pohlinkzei/PWM-Buck/README.md

# PWM-Buck
AVR-based control unit for car heating and ventilation in combination with an auxiliary heating

Its based on a Atmega88/168/328 AVR with a buck-converter power amplifier. It is made to driva a 
200W Motor for car heating and to display the water temperature, the temperature of the power 
transistors and the battery voltage. 

Here is where the development begun:
http://www.t4forum.de/wbb3/board19-technik-bereich/board120-umbauten-tuning/board8-tipps-und-tricks/165848-gemeinschaftsentwicklung-t4forums-pwm-modul/
