pohlinkzei/PWM-Buck/PWM-Buck/layout/PWM Buck V1.brd

## EAGLE design PWM-Buck/layout/PWM Buck V1.brd (2016-06-30)

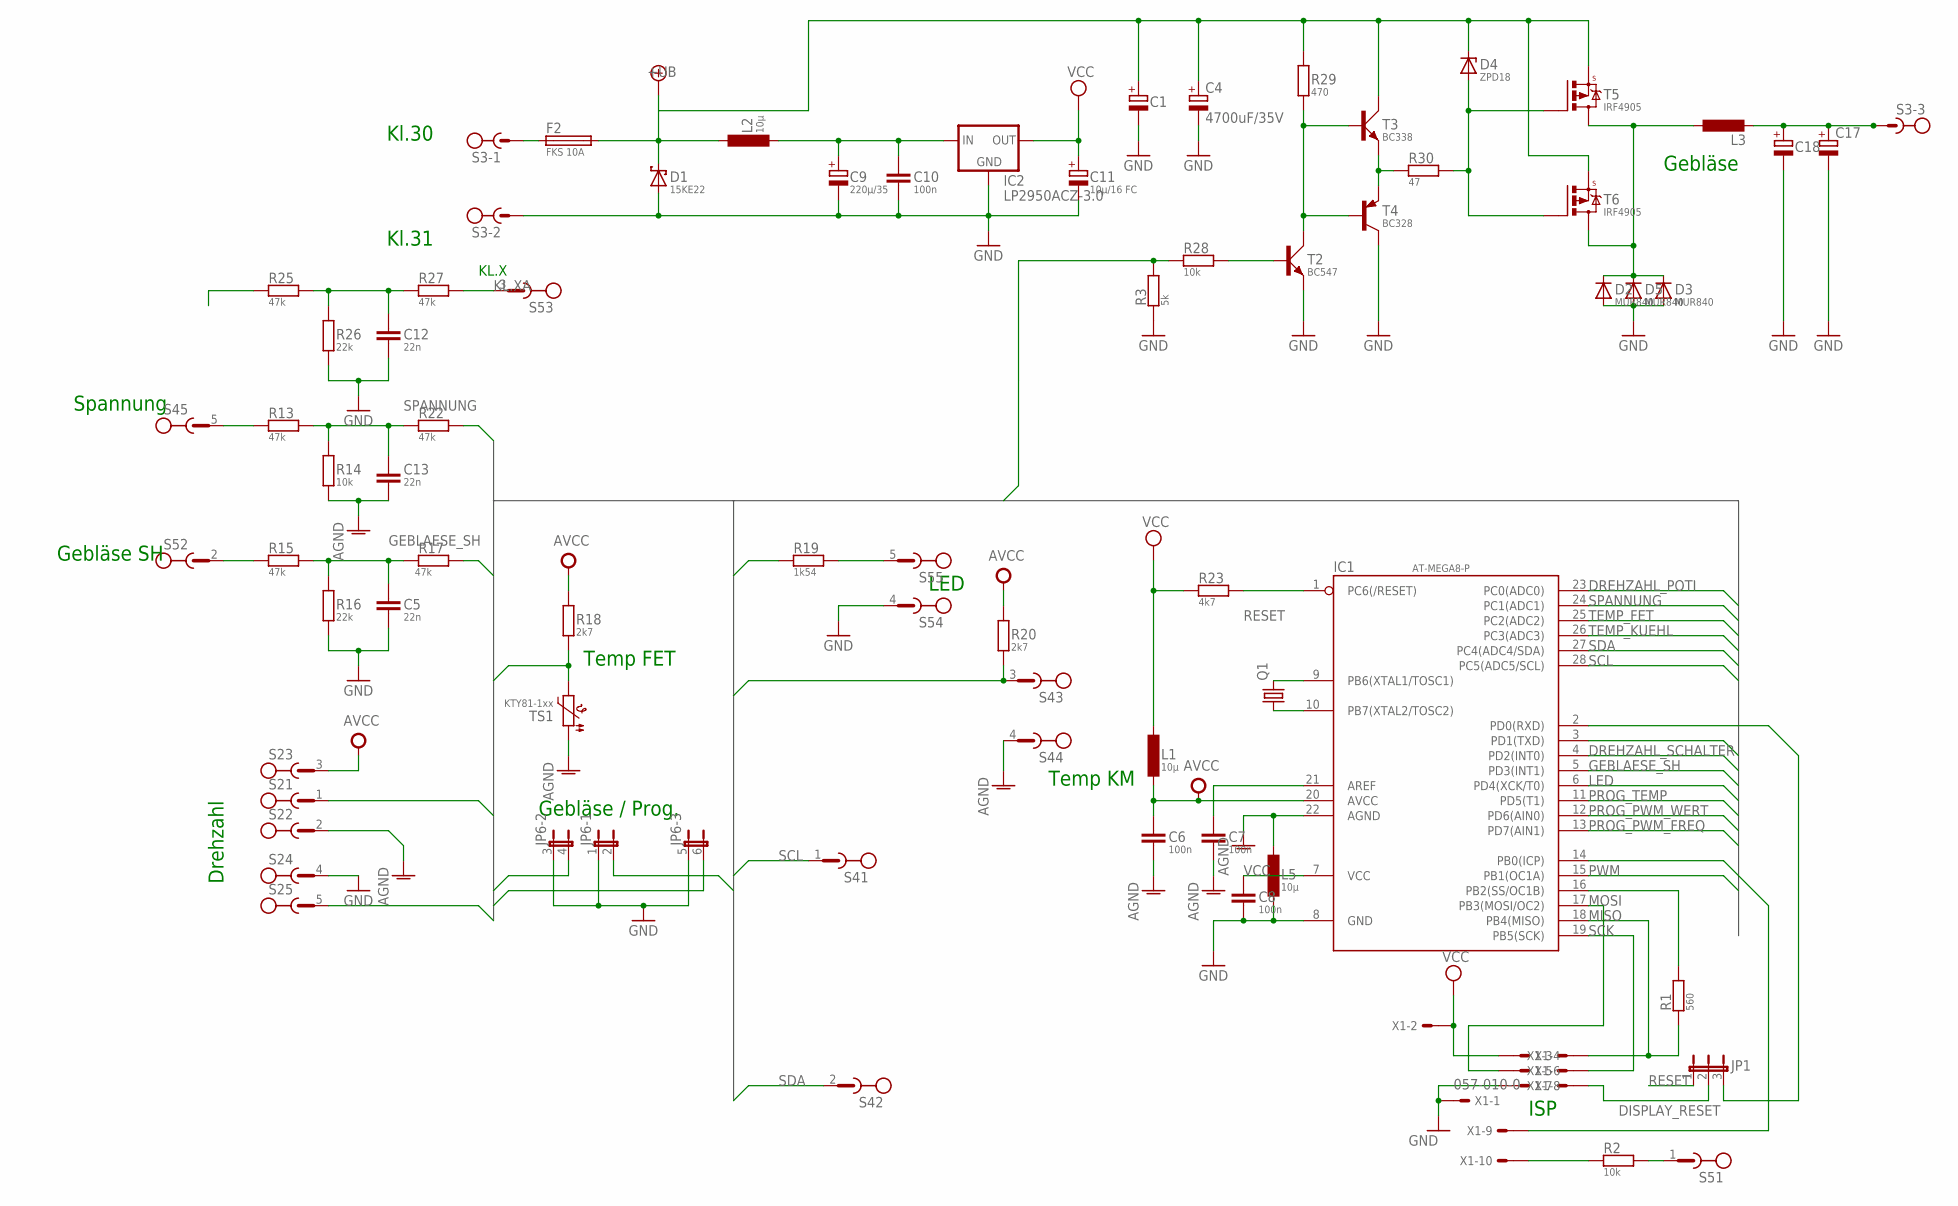
[picture p1: schematic PWM Buck V1.sch]

Parts:
C1, C18: C_POL_5-10.5; E5-10.5
C4: 4700uF/35V; E7,5-18
C5, C12, C13: 22n; C_75_SCHMAL
C6, C7, C8: 100n; C_50_SCHMAL
C9: 220µ/35; E5-10.5
C10: 100n; C_75_SCHMAL
C11: 10µ/16 FC; E2.5-5
C17: CPOL-EUE5-13; E5-13
D1: 15KE22; DO201T15
D2, D3, D5: MUR840; TO220ACS
D4: ZPD18; DO35Z10
F2: FKS 10A; FKS
IC1: AT-MEGA8-P; AT-MEGA8P
IC2: LP2950ACZ-3.0; TO92
JP1: JP2E; JP2
JP6: JP3QE; JP3Q
L1, L2, L5: 10µ; L-2200-12,7
L3: L-EU0207/12; 0207/12
Q1: CRYSTALTC26V; TC26V
R1: 560; R_10
R2, R14, R28: 10k; R_10
R3: 5k; R_10
R13, R15, R17, R22, R25, R27: 47k; R_10
R16, R26: 22k; R_10
R18: 2k7; R_10
R19: 1k54; R_10
R20: 2k7; R_12
R23: 4k7; R_10
R29: 470; R_10
R30: 47; R_10
S2: CON-PLATINE_5-POLIG
S3: CON-RIA-220-03; RIA-220-03
S4, S5: CON-RIA-183-05; RIA-183-05
T2: BC547; SOT54A-WIDE
T3: BC338; SOT54A-WIDE
T4: BC328; TO92_WIDE
T5, T6: IRF4905; TO220BV
TS1: KTY81-1xx; SOD70
X1: 057-010-0

Connections:
+UB: C1.+, C4.+, D1.C, D4.C, F2.2, L2.2, R29.2, T3.C, T5.S, T6.S
AGND: C6.2, C7.2, C13.1, IC1.22 (AGND), L5.2, R14.1, S2.2, S4.4, TS1.1
AVCC: C6.1, IC1.20 (AVCC), L1.1, R18.2, R20.2, S2.3
BEL_K58B: R2.2, X1.10
BEL_SH: IC1.14 (PB0(ICP)), X1.9
DISPLAY_RESET: JP1.2, X1.7
DREHZAHL_POTI: IC1.23 (PC0(ADC0)), S2.1
DREHZAHL_SCHALTER: IC1.4 (PD2(INT0)), S2.5
GATE: D4.A, R30.1, T5.G, T6.G
GEBLAESE_OUT: D2.C, D3.C, D5.C, L3.1, T5.D, T6.D
GEBLAESE_SH: IC1.5 (PD3(INT1)), R17.1
GND: C1.-, C4.-, C5.1, C8.2, C9.-, C10.2, C11.-, C12.1, C17.-, C18.-, D1.A, D2.A, D3.A, D5.A, IC1.8 (GND), IC2.2 (GND), JP6.1, JP6.3 (1), JP6.5 (1), L5.1, R3.2, R16.1, R26.1, S2.4, S3.2, S5.4, T2.E, T4.3 (C), X1.1, X1.8
KL.X: IC1.3 (PD1(TXD)), R25.1
KL.XA: R27.1, S5.3
LED: IC1.6 (PD4(XCK/T0)), R19.2
MISO: IC1.18 (PB4(MISO)), R1.1, X1.3
MOSI: IC1.17 (PB3(MOSI/OC2)), X1.6
unnamed: IC1.9 (PB6(XTAL1/TOSC1)), Q1.2
unnamed: IC1.10 (PB7(XTAL2/TOSC2)), Q1.1
unnamed: IC1.16 (PB2(SS/OC1B)), R1.2
unnamed: F2.1, S3.1
unnamed: IC1.2 (PD0(RXD)), JP1.3
unnamed: C5.2, R15.2, R16.2, R17.2
unnamed: C9.+, C10.1, IC2.3 (IN), L2.1
unnamed: R29.1, T2.C, T3.B, T4.2 (B)
unnamed: R2.1, S5.1
unnamed: C17.+, C18.+, L3.2, S3.3
unnamed: C7.1, IC1.21 (AREF)
unnamed: R28.1, T2.B
unnamed: R30.2, T3.E, T4.1 (E)
unnamed: C12.2, R25.2, R26.2, R27.2
unnamed: R19.1, S5.5
NIX: C13.2, R13.2, R14.2, R22.1
PROG_PWM_FREQ: IC1.13 (PD7(AIN1)), JP6.6 (2)
PROG_PWM_WERT: IC1.12 (PD6(AIN0)), JP6.4 (2)
PROG_TEMP: IC1.11 (PD5(T1)), JP6.2
PWM: IC1.15 (PB1(OC1A)), R3.1, R28.2
RESET: IC1.1 (PC6(/RESET)), JP1.1, R23.2
SCK: IC1.19 (PB5(SCK)), X1.5
SCL: IC1.28 (PC5(ADC5/SCL)), S4.1
SDA: IC1.27 (PC4(ADC4/SDA)), S4.2
SH: R15.1, S5.2
SPANNUNG: IC1.24 (PC1(ADC1)), R22.2
SPG: R13.1, S4.5
TEMP_FET: IC1.25 (PC2(ADC2)), R18.1, TS1.2
TEMP_KUEHL: IC1.26 (PC3(ADC3)), R20.1, S4.3
VCC: C8.1, C11.+, IC1.7 (VCC), IC2.1 (OUT), L1.2, R23.1, X1.2, X1.4

Notes on the sheet:
Drehzahl
Gebläse / Prog.
Temp FET
Temp KM
Kl.31
Kl.30
Spannung
LED
Gebläse SH
ISP
Gebläse
KL.X

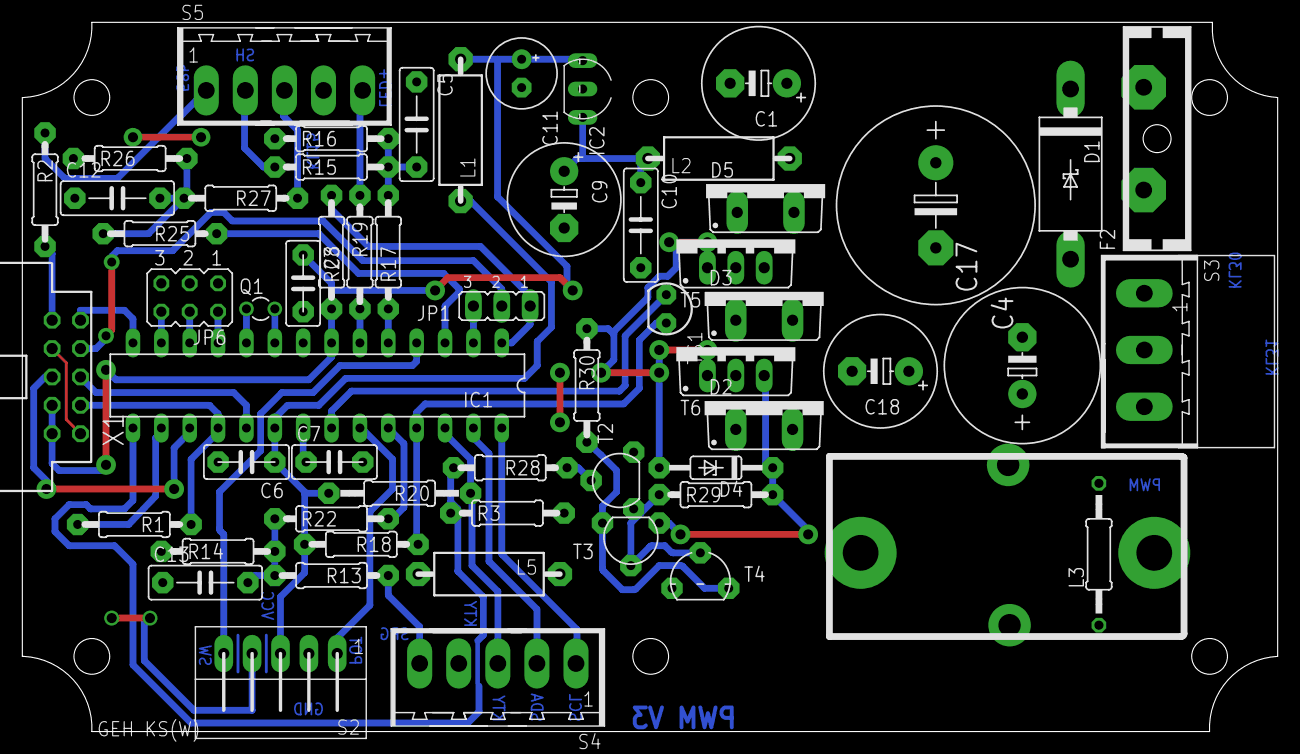
[picture p2: board PWM Buck V1.brd from above]

Board: 2 copper layers, 112.4 x 63.5 mm, 59 parts (0 on the bottom side), 47 nets.

Other parts of the board:
U$1: GEH_KSW_120X170
