pohlinkzei/PWM-Buck/PWM-Buck/layout/rpiabplusdogm128_1.brd

## EAGLE design PWM-Buck/layout/rpiabplusdogm128_1.brd (2015-08-27)

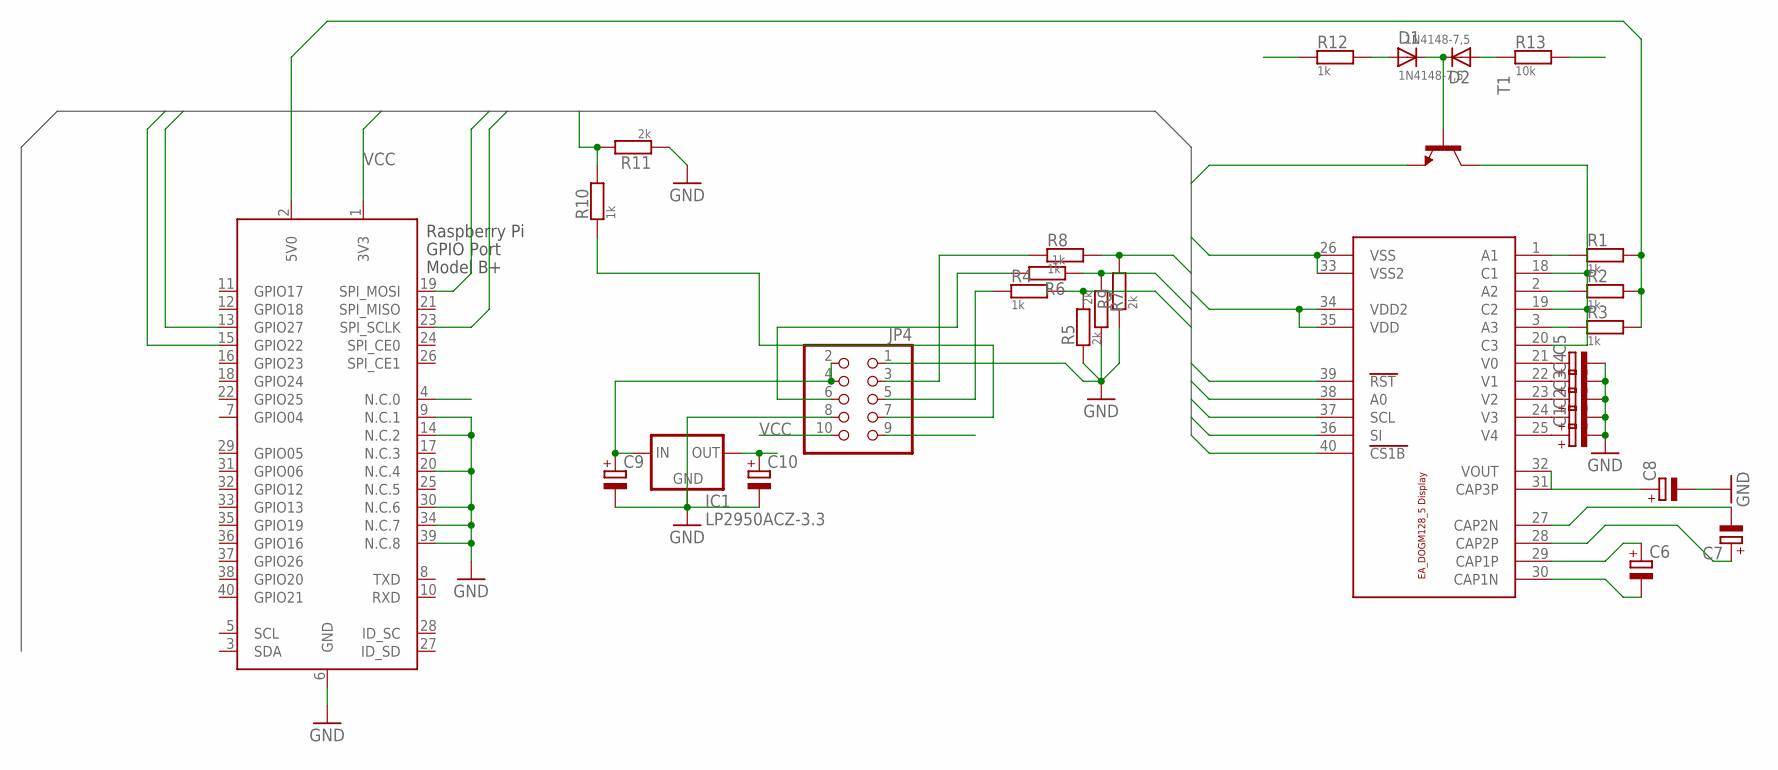
[picture p3: schematic rpiabplusdogm128_1.sch]

Parts:
C1, C2, C3, C4, C5, C6, C7, C8, C9, C10: CPOL-EUA/3216-18W; A/3216-18W
D1, D2: 1N4148-7,5; DO35-7,5
IC1: LP2950ACZ-3.3; TO92
JP4: PINHD-2X5_2.54-SMD; 2X05SMD
R1, R2, R3, R4, R6, R8, R10, R12: 1k; R_10
R5, R7, R9, R11: 2k; R_10
R13: 10k; R_10
T1: BC817-16-NPN-SOT23-BEC; SOT23-BEC
U$1: EA_DOG-M_DISPLAY; E_DOG-M_DISPLAY
X2: RASPI_BOARD_B+_H; RASPI_BOARD_B+HAT

Connections:
5V: C9.+, IC1.3 (IN), JP4.2, JP4.4, R1.2, R2.2, R3.2, X2.2 (5V0), X2.4 (N.C.0)
A0: R8.2, R9.2, U$1.38 (A0), X2.15 (GPIO22)
BELE: JP4.9, R12.1
BELK58B: JP4.10, R13.2
CS1B: U$1.40 (CS1B)
GND: C1.-, C2.-, C3.-, C4.-, C5.-, C8.-, C9.-, C10.-, IC1.2 (GND), JP4.1, JP4.8, R5.1, R7.2, R9.1, R11.1, T1.E, U$1.26 (VSS), U$1.33 (VSS2), X2.6 (GND), X2.9 (N.C.1), X2.14 (N.C.2), X2.20 (N.C.4), X2.30 (N.C.6), X2.34 (N.C.7), X2.39 (N.C.8)
unnamed: C1.+, U$1.25 (V4)
unnamed: R1.1, U$1.1 (A1)
unnamed: R2.1, U$1.2 (A2)
unnamed: R3.1, U$1.3 (A3)
unnamed: T1.C, U$1.18 (C1), U$1.19 (C2), U$1.20 (C3)
unnamed: JP4.7, R10.1
unnamed: JP4.5, R4.1
unnamed: JP4.6, R6.2
unnamed: JP4.3, R8.1
unnamed: D1.C, D2.C, T1.B
unnamed: D2.A, R13.1
unnamed: D1.A, R12.2
unnamed: C2.+, U$1.24 (V3)
unnamed: C3.+, U$1.23 (V2)
unnamed: C4.+, U$1.22 (V1)
unnamed: C5.+, U$1.21 (V0)
unnamed: C8.+, U$1.31 (CAP3P), U$1.32 (VOUT)
unnamed: C7.-, U$1.27 (CAP2N)
unnamed: C7.+, U$1.28 (CAP2P)
unnamed: C6.+, U$1.29 (CAP1P)
unnamed: C6.-, U$1.30 (CAP1N)
RST: R10.2, R11.2, U$1.39 (RST), X2.13 (GPIO27)
SCL: R4.2, R5.2, U$1.37 (SCL), X2.23 (SPI_SCLK)
SI: R6.1, R7.1, U$1.36 (SI), X2.19 (SPI_MOSI)
VCC: C10.+, IC1.1 (OUT), U$1.34 (VDD2), U$1.35 (VDD), X2.1 (3V3)

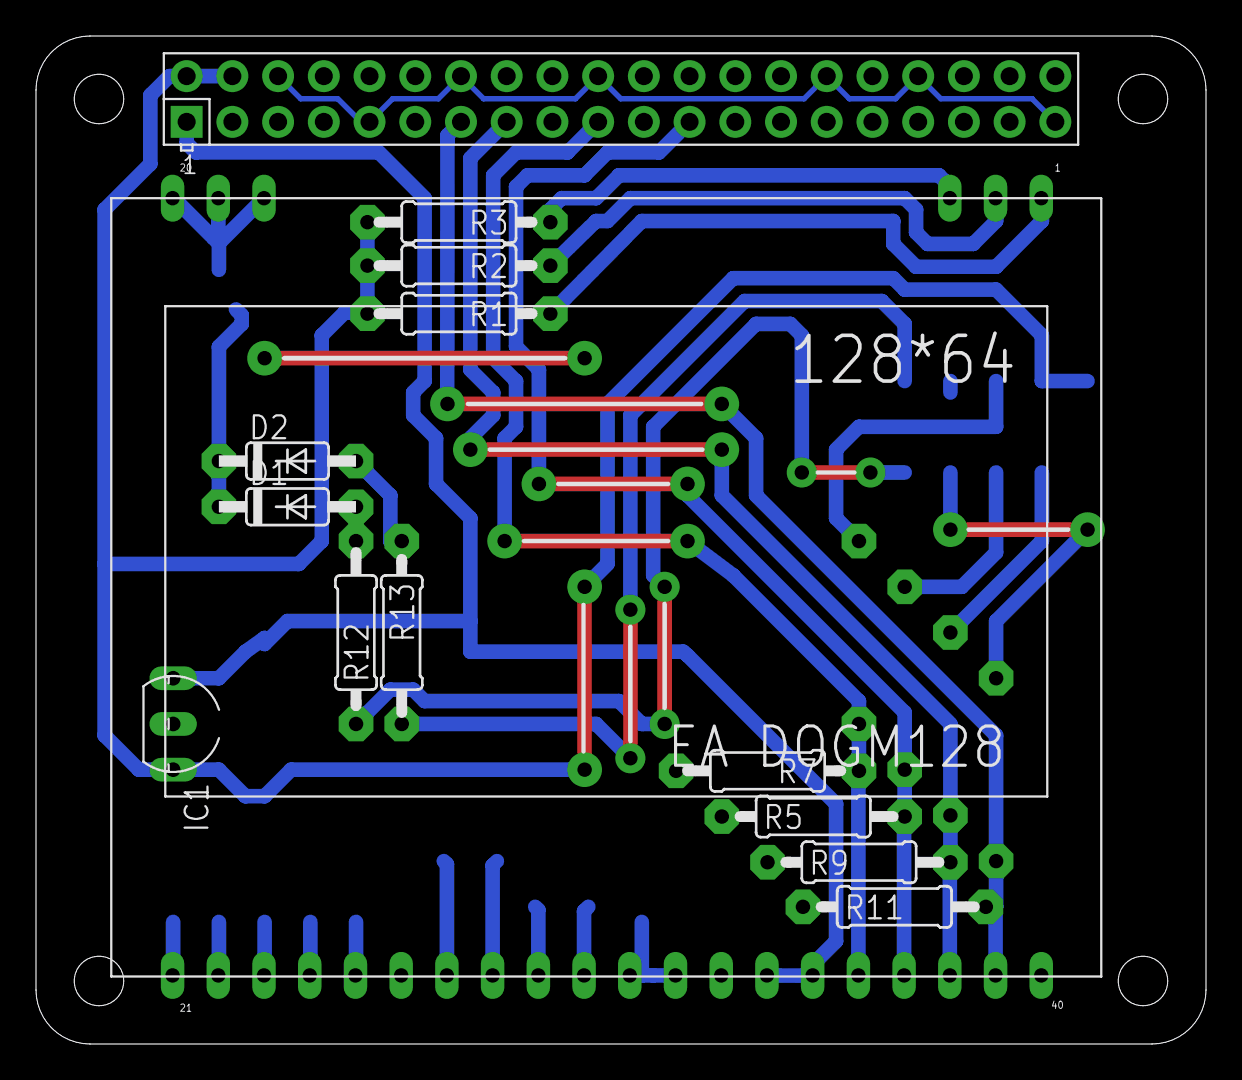
[picture p4: board rpiabplusdogm128_1.brd from above]

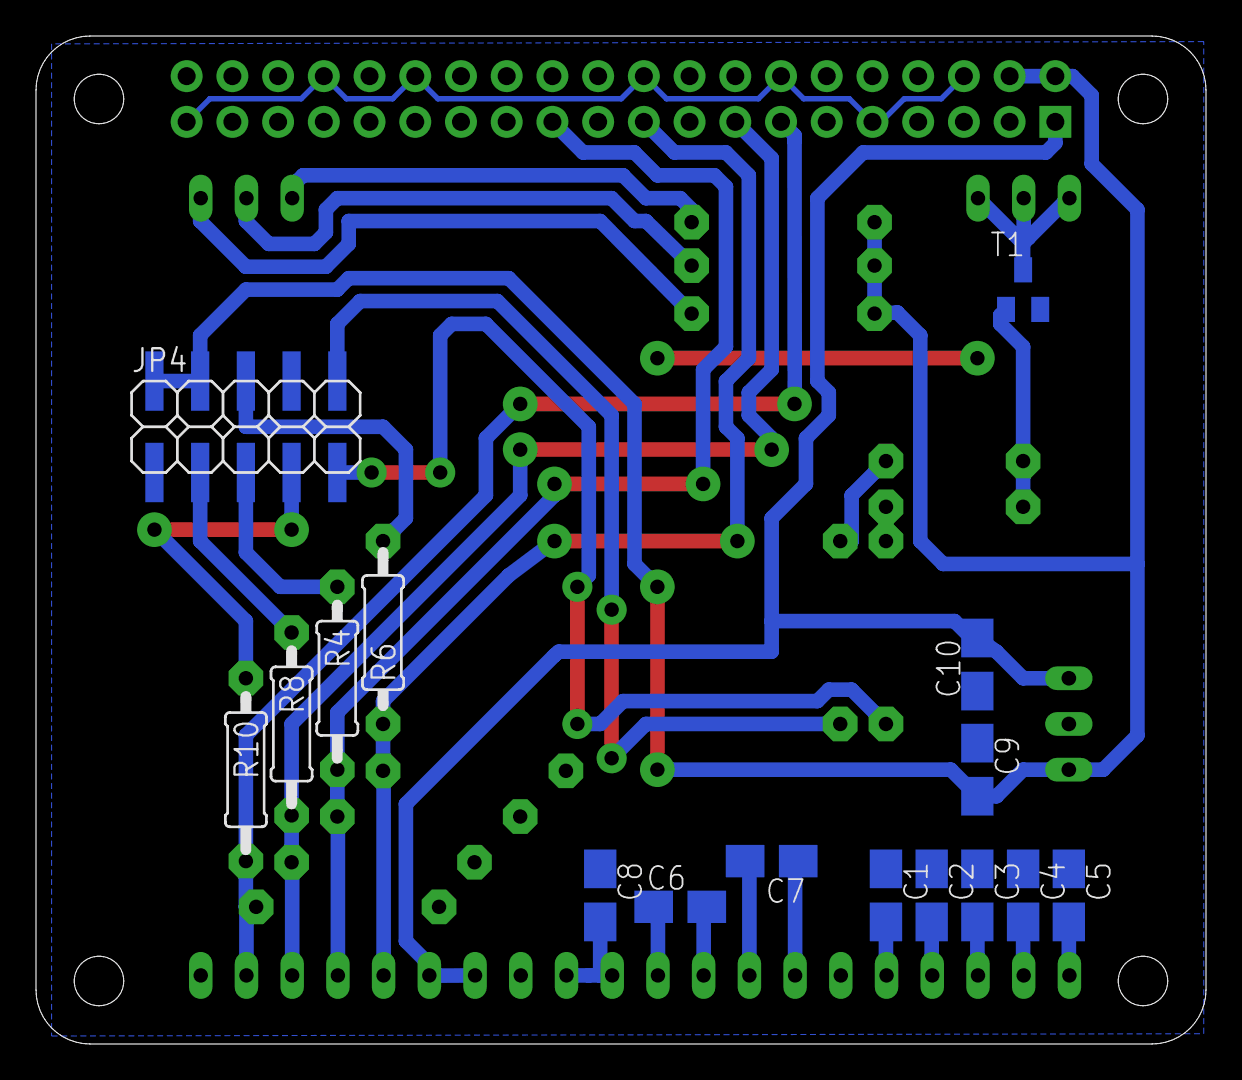
[picture p5: board rpiabplusdogm128_1.brd from below]

Board: 2 copper layers, 65.0 x 56.0 mm, 30 parts (16 on the bottom side), 30 nets.
