pohlinkzei/PWM-Buck/PWM-Buck/dog_display.h

#ifndef DOG_DISPLAY_H
#define DOG_DISPLAY_H
/** INCLUDES *********************************************************************************************************************/
#include <stdio.h>
#include <avr/io.h>
#include <util/delay.h>
#include <avr/pgmspace.h>
/** DEFINES **********************************************************************************************************************/

#define CHARSET_ASCII  // uncomment to use a reduced charset to save memory
//#define CHARSET_SYMBOLS //  
//#define USE_TINY_FONT	// uncomment to use tiny font to save memory
#define USE_SMALL_FONT	// uncomment to use small font to save memory
#define USE_MID_FONT	// uncomment to use mid to save memory
#define USE_BIG_FONT	// uncomment to use big to save memory
//*
#ifdef CHARSET_ASCII
#define CHARSET 128//96
#else
#define CHARSET 256 
#endif
//*/
#define SIZE4X6 4
#define SIZE6X8 6
#define SIZE8X12 8
#define SIZE12X16 12

#define FUEL 0
#define DOOR 2
#define FROST 4
#define ENGT 6
#define OILT 8
#define CONS 10
#define BAT 13
#define KMH 15
#define RPM 17

#define USE_DOGM128
#define COLUMNS 132
#define ROWS 8//4

#define DOG_A0 PB2
#define DOG_A0_DDR DDRB
#define DOG_A0_PORT PORTB
/*#define CS1B 0x00*/
#define DOG_RST PD0
#define DOG_RST_DDR DDRD
#define DOG_RST_PORT PORTD

#define SPI_DDR DDRB
#define MOSI PB3
#define MISO PB4
#define SCK PB5

//dog COMMANDS
#define LCD_ON			0xAF
#define LCD_OFF			0xAE
#define SET_PAGE		0xB0
#define SET_ADDRESS0	0x10
#define SET_ADDRESS1	0x00
#define NORMAL			0xA6
#define REVERSE			0xA7
#define ALL_OFF			0xA4
#define ALL_ON			0xA5
#define BIAS_SET_7		0xA3
#define BIAS_SET_9		0xA2
#define RESET			0xE2
#define MODE_SEL_NOR	0xC0
#define MODE_SEL_REV	0xC8
#define RES_SET			0x20
#define PWR_SAVE		0x00
#define NOP				0xE3
/** MACROS ***********************************************************************************************************************/
#define DOG_A0_HIGH()	DOG_A0_PORT		|= (1<<DOG_A0);
#define DOG_A0_LOW() 	DOG_A0_PORT		&= ~(1<<DOG_A0);
#define DOG_RST_HIGH() 	DOG_RST_PORT	|= (1<<DOG_RST);
#define DOG_RST_LOW() 	DOG_RST_PORT	&= ~(1<<DOG_RST);

/** TYPES ************************************************************************************************************************/
typedef struct position {uint8_t page; uint8_t column; uint8_t row;} position_t;

/** FUNCTIONS ********************************************************************************************************************/
void dog_init(void);
void dog_spi_init(void);
//void dog_uart_spi_init(uint16_t baud);
uint8_t dog_transmit(uint8_t data);

void dog_transmit_data(uint8_t data);
#ifdef USE_SMALL_FONT
void dog_write_small_digit(uint8_t digit);
void dog_write_small_string(char *data);
#endif
#ifdef USE_BIG_FONT
void dog_write_big_digit(position_t position,uint8_t digit);
void dog_write_big_string(position_t position,char *data);
#endif
#ifdef USE_MID_FONT
void dog_write_mid_digit(position_t position,uint8_t digit);
void dog_write_mid_string(position_t position,char *data);
void dog_write_mid_strings(position_t pos, char* str0, char* str1);
#endif
#ifdef USE_TINY_FONT
void dog_write_tiny_digit(uint8_t digit);
void dog_write_tiny_string(char *data);
#endif
void dog_set_page(uint8_t page);
position_t NEW_POSITION(uint8_t page,uint8_t column);
position_t NEW__POSITION(uint8_t page,uint8_t column, uint8_t row);
position_t dog_set_position(uint8_t page,uint8_t column);
void dog_clear_lcd(void);
void dog_home(void);
void dog_write_empty_line(position_t p);
void dog_write_numbered_bat_symbol(position_t position, uint8_t num);
void dog_write_rotating(position_t position, char* text, uint8_t length, uint8_t type, volatile uint16_t tim);
/** PROGMEM **********************************************************************************************************************/
static const char font4x6[CHARSET][4] PROGMEM ={
//#ifndef CHARSET_ASCII
{0x00,0x00,0x00,0x00},	// 0x00
{0x00,0x38,0x54,0x38},	// 0x01
{0x00,0x38,0x6C,0x38},	// 0x02
{0x00,0x38,0x70,0x38},	// 0x03
{0x00,0x30,0x78,0x30},	// 0x04
{0x00,0x58,0x7C,0x58},	// 0x05
{0x00,0x50,0x7C,0x50},	// 0x06
{0x00,0x00,0x00,0x00},	// 0x07
{0x00,0x00,0x00,0x00},	// 0x08
{0x00,0x00,0x00,0x00},	// 0x09
{0x00,0x00,0x00,0x00},	// 0x0A
{0x00,0x60,0x68,0x18},	// 0x0B
{0x00,0x28,0x74,0x28},	// 0x0C
{0x00,0x00,0x00,0x00},	// 0x0D
{0x00,0x10,0x4C,0x38},	// 0x0E
{0x00,0x38,0x6C,0x38},	// 0x0F
{0x00,0x7C,0x38,0x10},	// 0x10
{0x00,0x10,0x38,0x7C},	// 0x11
{0x00,0x28,0x7C,0x28},	// 0x12
{0x00,0x5C,0x00,0x5C},	// 0x13
{0x00,0x00,0xF0,0x08},	// 0x14
{0x00,0x40,0x3C,0x00},	// 0x15
{0x00,0x40,0x40,0x40},	// 0x16
{0x00,0xA8,0xFC,0xA8},	// 0x17
{0x00,0x08,0x7C,0x08},	// 0x18
{0x00,0x20,0x7C,0x20},	// 0x19
{0x10,0x10,0x38,0x10},	// 0x1A
{0x10,0x38,0x10,0x10},	// 0x1B
{0x00,0x30,0x20,0x20},	// 0x1C
{0x00,0x38,0x10,0x38},	// 0x1D
{0x00,0x30,0x38,0x30},	// 0x1E
{0x00,0x18,0x38,0x18},	// 0x1F
//#endif
{0x00,0x00,0x00,0x00},	// 0x20
{0x00,0x00,0x5C,0x00},	// 0x21
{0x00,0x0C,0x00,0x0C},	// 0x22
{0x00,0x7C,0x28,0x7C},	// 0x23
{0x00,0x50,0xFC,0x28},	// 0x24
{0x00,0x24,0x10,0x48},	// 0x25
{0x00,0x68,0x54,0x78},	// 0x26
{0x00,0x0C,0x04,0x00},	// 0x27
{0x00,0x38,0x44,0x00},	// 0x28
{0x00,0x44,0x38,0x00},	// 0x29
{0x00,0x54,0x38,0x54},	// 0x2A
{0x00,0x10,0x38,0x10},	// 0x2B
{0x00,0xC0,0x40,0x00},	// 0x2C
{0x00,0x10,0x10,0x10},	// 0x2D
{0x00,0x00,0x40,0x00},	// 0x2E
{0x00,0x60,0x10,0x0C},	// 0x2F
{0x00,0x78,0x44,0x3C},	// 0x30
{0x00,0x48,0x7C,0x40},	// 0x31
{0x00,0x64,0x54,0x48},	// 0x32
{0x00,0x44,0x54,0x28},	// 0x33
{0x00,0x18,0x10,0x7C},	// 0x34
{0x00,0x5C,0x54,0x24},	// 0x35
{0x00,0x38,0x54,0x20},	// 0x36
{0x00,0x04,0x74,0x1C},	// 0x37
{0x00,0x28,0x54,0x28},	// 0x38
{0x00,0x08,0x54,0x38},	// 0x39
{0x00,0x00,0x50,0x00},	// 0x3A
{0x00,0xC0,0x50,0x00},	// 0x3B
{0x00,0x10,0x28,0x44},	// 0x3C
{0x00,0x50,0x50,0x50},	// 0x3D
{0x00,0x44,0x28,0x10},	// 0x3E
{0x00,0x04,0x54,0x08},	// 0x3F
{0x00,0x7C,0x44,0x5C},	// 0x40
{0x00,0x78,0x14,0x78},	// 0x41
{0x00,0x7C,0x54,0x28},	// 0x42
{0x00,0x38,0x44,0x44},	// 0x43
{0x00,0x7C,0x44,0x38},	// 0x44
{0x00,0x7C,0x54,0x44},	// 0x45
{0x00,0x7C,0x14,0x04},	// 0x46
{0x00,0x38,0x44,0x74},	// 0x47
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
#ifndef CHARSET_ASCII
,
{0x00,0xB8,0x64,0x24},	// 0x80
{0x00,0x34,0x40,0x74},	// 0x81
{0x00,0x30,0x78,0x54},	// 0x82
{0x00,0x68,0x54,0x78},	// 0x83
{0x00,0x64,0x50,0x74},	// 0x84
{0x00,0x64,0x58,0x70},	// 0x85
{0x00,0x60,0x54,0x70},	// 0x86
{0x00,0xB8,0xE8,0x28},	// 0x87
{0x00,0x38,0x74,0x58},	// 0x88
{0x00,0x34,0x70,0x54},	// 0x89
{0x00,0x34,0x78,0x50},	// 0x8A
{0x00,0x04,0x70,0x04},	// 0x8B
{0x00,0x08,0x64,0x08},	// 0x8C
{0x00,0x04,0x68,0x00},	// 0x8D
{0x00,0x74,0x28,0x74},	// 0x8E
{0x00,0x70,0x2C,0x70},	// 0x8F
{0x00,0x70,0x78,0x54},	// 0x90
{0x00,0x60,0x70,0x30},	// 0x91
{0x00,0x78,0x7C,0x54},	// 0x92
{0x00,0x28,0x54,0x28},	// 0x93
{0x00,0x24,0x50,0x24},	// 0x94
{0x00,0x24,0x58,0x20},	// 0x95
{0x00,0x68,0x44,0x68},	// 0x96
{0x00,0x74,0x48,0x70},	// 0x97
{0x00,0xB4,0x40,0x34},	// 0x98
{0x00,0x34,0x48,0x34},	// 0x99
{0x00,0x74,0x40,0x74},	// 0x9A
{0x00,0x38,0x6C,0x28},	// 0x9B
{0x00,0x50,0x78,0x54},	// 0x9C
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
B* 	░ 	▒ 	▓ 	│ 	┤ 	Á 	Â 	À 	© 	╣ 	║ 	╗ 	╝ 	¢ 	¥ 	┐
C* 	└ 	┴ 	┬ 	├ 	─ 	┼ 	ã 	Ã 	╚ 	╔ 	╩ 	╦ 	╠ 	═ 	╬ 	¤
D* 	ð 	Ð 	Ê 	Ë 	È 	ı 	Í 	Î 	Ï 	┘ 	┌ 	█ 	▄ 	¦ 	Ì 	▀
E* 	Ó 	ß 	Ô 	Ò 	õ 	Õ 	µ 	þ 	Þ 	Ú 	Û 	Ù 	ý 	Ý 	¯ 	´
F* 	­ 	± 	‗ 	¾ 	¶ 	§ 	÷ 	¸ 	° 	¨ 	· 	¹ 	³ 	² 	■ 	 

*/
