pohlinkzei/PWM-Buck/(commit log)

2015-08-27 Add: Layout
    [PWM Buck V1.brd, PWM Buck V1.sch, rpiabplusdogm128_1.brd, rpiabplusdogm128_1.sch]
2015-08-27 fix: Symbols for FET temperature and water temperature
    [dog_display.h]
2015-09-23 Add working i2c interface
2015-12-16 update: switch off pwm output for power down
2015-12-17 update: twi and power off pwm
2016-02-03 Fix twi - tested and working now...
    [PWM-Buck.c, pwm.c, twi_slave.h, twi_task.c]
2016-06-30 minor changes
    [PWM Buck V1.brd, PWM Buck V1.sch]
